w1xm/quantar-interface/README.md

# quantar-interface
Interfaces a Motorola Quantar repeater to a PC or Raspberry Pi for use with the AllStarLink controller.
