w1xm/quantar-interface/docs/EEPROM.md

# EEPROM

The interface board contains a 93C46 EEPROM chip that stores USB device
information and audio path settings for the CM119A. It is composed of 64x
16-bit words (128 bytes total)

## Format

The format is described in section 7.1.3 of the CM119A datasheet. Note, however,
that length fields for the serial, product, and manufacturer strings should be 
calculated: `2 * (real string length + 1)`. E.g., the string "ACME, Inc" should
be programmed with length `2*(9 + 1) = 20 or 0x14`. The datasheet does not make
this clear; this was determined with trial and error until I noticed the pattern.

### EEPROM contents used in device

This is a hex dump of the EEPROM as used in quantar-interface

```
Word
Address   0/8  1/9  2/A  3/B   4/C  5/D  6/E  7/F
00000000: 6707 0d8c 013a 300c  3030 3130 0000 0000  .g..:..0 0001....
00000008: 0000 0000 5130 6175  746e 7261 4920 746e  ....0Qua ntar Int
00000010: 7265 6166 6563 5220  7665 4120 0000 0000  erface R ev A....
00000018: 0000 0000 4b0e 3844  4859 0042 0000 0000  .....KD8 YHB.....
00000020: 0000 0000 0000 0000  0000 0000 0000 0000  ........ ........
00000028: 0000 0000 ffff ffff  ffff ffff ffff ffff  ........ ........
00000030: ffff ffff ffff ffff  ffff ffff ffff ffff  ........ ........
00000038: ffff ffff ffff ffff  ffff ffff ffff ffff  ........ ........
```

See `quantar_interface_eeprom.bin`. Mind the endianness.

 * VID = `0x0d8c` (C-Media, default)
 * PID = `0x013a` (default)
 * SN = `"00001"` (ASCII, please change this to something unique, len 0x0c)
 * Product = `"Quantar Interface Rev A"` (len 0x30)
 * Mfg = `"KD8YHB"` (len 0x0e)

## Programming
Is it possible to access the EEPROM via USB HID, but I didn't want to deal with
writing a tool for that, so I simply use an XGecu TL866-II universal programmer
to write in the data, then solder the chip to the board.
