w1xm/quantar-interface/pcb/quantar-interface/master_bom.ods

Ref | Qnty | Value | Footprint | Description | Vendor | Part #
C1, C7, C18, | 3 | 4.7uF | Capacitor_SMD:CP_Elec_4x5.4 | Polarized capacitor | DK | PCE4290CT-ND
C2, C6, C14, C32, C35, C36, | 6 | 0.1uF | Capacitor_SMD:C_0805_2012Metric_Pad1.15x1.40mm_HandSolder | Unpolarized capacitor | LCSC | C49678
C3, C4, | 2 | 47p | Capacitor_SMD:C_0805_2012Metric_Pad1.15x1.40mm_HandSolder | Unpolarized capacitor | LCSC | C14857
C5, C9, C11, C12, C16, | 5 | 47uF | Capacitor_SMD:CP_Elec_6.3x5.4 | Polarized capacitor | DK | PCE3961CT-ND
C8, C13, | 2 | 4.7uF | Capacitor_SMD:C_0805_2012Metric_Pad1.15x1.40mm_HandSolder | Unpolarized capacitor | LCSC | C1779
C15, C34, | 2 | 47pF | Capacitor_SMD:C_0805_2012Metric_Pad1.15x1.40mm_HandSolder | Unpolarized capacitor | LCSC | C14857
C17, C24, C27, | 3 | 0.47uF | Capacitor_SMD:C_1206_3216Metric_Pad1.42x1.75mm_HandSolder | Polarized capacitor | DK | 399-3695-1-ND
C19, C23, | 2 | 22uF | Capacitor_SMD:CP_Elec_6.3x5.4 | Polarized capacitor | DK | PCE3899CT-ND
C20, C25, C26, C28, | 4 | 10uF | Capacitor_SMD:CP_Elec_4x5.8 | Polarized capacitor | DK | PCE3782CT-ND
C21, C22, | 2 | 12pF | Capacitor_SMD:C_0805_2012Metric_Pad1.15x1.40mm_HandSolder | Unpolarized capacitor | LCSC | C1792
C29, C33, | 2 | 1uF | Capacitor_SMD:CP_Elec_4x4.5 | Polarized capacitor | DK | PCE3912CT-ND
C31, | 1 | 0.01uF | Capacitor_SMD:C_0805_2012Metric_Pad1.15x1.40mm_HandSolder | Unpolarized capacitor | LCSC | C1710
D1, | 1 | LED_USB | LED_SMD:LED_0805_2012Metric_Pad1.15x1.40mm_HandSolder | Light emitting diode | LCSC | C2297
D2, D3, | 2 | B340LA | Diode_SMD:D_SMA_Handsoldering | Schottky diode | DK | B340LA-FDICT-ND
D4, D5, D6, D7, | 4 | TVS | Diode_SMD:D_SOD-323_HandSoldering | Bidirectional transient-voltage-suppression diode | DK | DF2B7AFUH3FCT-ND
D8, | 1 | LED_12V | LED_SMD:LED_0805_2012Metric_Pad1.15x1.40mm_HandSolder | Light emitting diode | LCSC | C2297
D9, | 1 | LED_5VD | LED_SMD:LED_0805_2012Metric_Pad1.15x1.40mm_HandSolder | Light emitting diode | LCSC | C2297
D10, | 1 | LED_5VA | LED_SMD:LED_0805_2012Metric_Pad1.15x1.40mm_HandSolder | Light emitting diode | LCSC | C2297
D11, | 1 | LED_HEARTBEAT | LED_SMD:LED_0805_2012Metric_Pad1.15x1.40mm_HandSolder | Light emitting diode | LCSC | C2297
D12, D14, | 2 | 1N4148 | Diode_SMD:D_SOD-523 | Diode | DK | 1N4148XTPMSCT-ND
D13, | 1 | LED_ALARM | LED_SMD:LED_0805_2012Metric_Pad1.15x1.40mm_HandSolder | Light emitting diode | LCSC | C84256
D15, | 1 | LED_SPARE_OUT | LED_SMD:LED_0805_2012Metric_Pad1.15x1.40mm_HandSolder | Light emitting diode | LCSC | C2296
D16, | 1 | LED_PTT | LED_SMD:LED_0805_2012Metric_Pad1.15x1.40mm_HandSolder | Light emitting diode | LCSC | C2296
D17, | 1 | LED_WDOG | LED_SMD:LED_0805_2012Metric_Pad1.15x1.40mm_HandSolder | Light emitting diode | LCSC | C2297
D18, | 1 | LED_PL | LED_SMD:LED_0805_2012Metric_Pad1.15x1.40mm_HandSolder | Light emitting diode | LCSC | C2296
D19, | 1 | LED_COS | LED_SMD:LED_0805_2012Metric_Pad1.15x1.40mm_HandSolder | Light emitting diode | LCSC | C2296
D20, | 1 | LED_FS | LED_SMD:LED_0805_2012Metric_Pad1.15x1.40mm_HandSolder | Light emitting diode | LCSC | C2296
D21, | 1 | LED_TI | LED_SMD:LED_0805_2012Metric_Pad1.15x1.40mm_HandSolder | Light emitting diode | LCSC | C84256
D22, | 1 | LED_SD | LED_SMD:LED_0805_2012Metric_Pad1.15x1.40mm_HandSolder | Light emitting diode | LCSC | C2296
D23, | 1 | LED_SI | LED_SMD:LED_0805_2012Metric_Pad1.15x1.40mm_HandSolder | Light emitting diode | LCSC | C2296
F1, F2, | 2 | PTC 3A | Fuse:Fuse_2920_7451Metric_Pad2.10x5.45mm_HandSolder | Resettable fuse, polymeric positive temperature coefficient, small symbol | DK | ‎SMDC300F/24-2CT-ND‎
F3, F4, | 2 | PTC 1A | Fuse:Fuse_1210_3225Metric_Pad1.42x2.65mm_HandSolder | Resettable fuse, polymeric positive temperature coefficient, small symbol | DK | 507-1786-1-ND
FB1, FB2, | 2 | Ferrite_Bead_Small | Inductor_SMD:L_0805_2012Metric_Pad1.15x1.40mm_HandSolder | Ferrite bead, small symbol | DK | 240-2551-1-ND
FB3, | 1 | Ferrite | Inductor_SMD:L_0805_2012Metric_Pad1.15x1.40mm_HandSolder | Ferrite bead, small symbol | DK | 240-2551-1-ND
J1, | 1 | DC Input | Connector_BarrelJack:BarrelJack_Horizontal | DC Barrel Jack with an internal switch | DK | CP-002A-ND
J2, | 1 | USB_A | Connector_USB:USB_A_Stewart_SS-52100-001_Horizontal | USB Type A connector | DK | SS-52100-001
J3, | 1 | USB_B | Connector_USB:USB_B_OST_USB-B1HSxx_Horizontal | USB Type B connector | DK | ED2983-ND
J4, | 1 | GPIO | Connector_PinHeader_2.54mm:PinHeader_1x03_P2.54mm_Vertical | Generic connector, single row, 01x03, script generated (kicad-library-utils/schlib/autogen/connector/) | Generic | 0.1” header
J5, | 1 | Quantar Audio | Connector_Phoenix_MC:PhoenixContact_MC_1,5_5-G-3.5_1x05_P3.50mm_Horizontal | Generic screw terminal, single row, 01x05, script generated (kicad-library-utils/schlib/autogen/connector/) | DK | WM7773-ND
J6, | 1 | Ext. Alarm Contact | Connector_Phoenix_MC:PhoenixContact_MC_1,5_3-G-3.5_1x03_P3.50mm_Horizontal | Generic screw terminal, single row, 01x03, script generated (kicad-library-utils/schlib/autogen/connector/) | DK | WM7771-ND
J7, | 1 | Ext. TX Inhb. | Connector_Phoenix_MC:PhoenixContact_MC_1,5_2-G-3.5_1x02_P3.50mm_Horizontal | Generic screw terminal, single row, 01x02, script generated (kicad-library-utils/schlib/autogen/connector/) | DK | WM7770-ND
J8, | 1 | Quantar | Connector_Phoenix_MC:PhoenixContact_MC_1,5_13-G-3.5_1x13_P3.50mm_Horizontal | Generic screw terminal, single row, 01x13, script generated (kicad-library-utils/schlib/autogen/connector/) | DK | WM7781-ND
J9, | 1 | 5V Out | Connector_PinHeader_2.54mm:PinHeader_1x02_P2.54mm_Vertical | Generic connector, single row, 01x02, script generated (kicad-library-utils/schlib/autogen/connector/) | Generic | 0.1” header
JP2, | 1 | Watchdog Bypass | Connector_PinHeader_2.54mm:PinHeader_1x03_P2.54mm_Vertical | Jumper, 3-pole, pins 1+2 closed/bridged | Generic | 0.1” header
K1, | 1 | G6S-2 | Relay_THT:Relay_DPDT_Omron_G6S-2 | Compact, Industry-Standard 2-pole relay, designed to switch 2A Signal Loads, Single-side Stable | DK | 399-11029-5-ND
L1, | 1 | 33uH | Inductor_SMD:L_12x12mm_H4.5mm | Inductor | DK | P19782CT-ND
L2, | 1 | 4.7uH | Inductor_SMD:L_1008_2520Metric | Inductor | DK | 587-2187-1-ND
Q1, | 1 | DMP3056L-7 | Package_TO_SOT_SMD:SOT-23 | P-MOSFET transistor, gate/source/drain | DK | DMP3056L-7DICT-ND
Q2, Q3, Q4, Q5, Q6, | 5 | 2N7002 | Package_TO_SOT_SMD:SOT-23 | 0.115A Id, 60V Vds, N-Channel MOSFET, SOT-23 | LCSC | C8545
R1, R14, R16, R17, R23, R24, R25, R26, R27, R28, R29, R30, R31, R32, R33, R38, R39, R41, R42, R43, R44, | 21 | 330 | Resistor_SMD:R_0805_2012Metric_Pad1.15x1.40mm_HandSolder | Resistor | LCSC | C17630
R2, R3, R45, | 3 | 22 | Resistor_SMD:R_0805_2012Metric_Pad1.15x1.40mm_HandSolder | Resistor | LCSC | C17561
R6, | 1 | 1.5K | Resistor_SMD:R_0805_2012Metric_Pad1.15x1.40mm_HandSolder | Resistor | LCSC | C4310
R7, R8, R9, R40, | 4 | 0 | Resistor_SMD:R_0805_2012Metric_Pad1.15x1.40mm_HandSolder | Resistor | LCSC | C17477
R10, | 1 | 75K 1% | Resistor_SMD:R_0805_2012Metric_Pad1.15x1.40mm_HandSolder | Resistor | LCSC | C17819
R11, | 1 | 10K 1% | Resistor_SMD:R_0805_2012Metric_Pad1.15x1.40mm_HandSolder | Resistor | LCSC | C17414
R12, R20, | 2 | 1M | Resistor_SMD:R_0805_2012Metric_Pad1.15x1.40mm_HandSolder | Resistor | LCSC | C17514
R13, R22, | 2 | 2.2K | Resistor_SMD:R_0805_2012Metric_Pad1.15x1.40mm_HandSolder | Resistor | LCSC | C17520
R15, | 1 | 100K | Resistor_SMD:R_0805_2012Metric_Pad1.15x1.40mm_HandSolder | Resistor | LCSC | C17407
R18, R19, R21, | 3 | 4.7K | Resistor_SMD:R_0805_2012Metric_Pad1.15x1.40mm_HandSolder | Resistor | LCSC | C17673
R34, R35, R36, R37, R46, | 5 | 10K | Resistor_SMD:R_0805_2012Metric_Pad1.15x1.40mm_HandSolder | Resistor | LCSC | C17414
RV1, RV2, | 2 | 100K | Potentiometer_THT:Potentiometer_Bourns_3296W_Vertical | Potentiometer | DK | 490-2876-ND
SW1, | 1 | SW_TX_INHB | Button_Switch_THT:SW_Slide_1P2T_CK_OS102011MS2Q | Switch, single pole double throw | DK | CKN9542-ND
SW2, | 1 | SW_PTT_INHB | Button_Switch_THT:SW_Slide_1P2T_CK_OS102011MS2Q | Switch, single pole double throw | DK | CKN9542-ND
SW3, | 1 | Force PTT | Button_Switch_SMD:SW_Push_1P1T_NO_CK_KMR2 | Pushbutton | DK | 401-1431-1-ND
T1, T2, | 2 | Transformer | quantar-interface:Transformer | 1:1 Isolation transformer for quantar phone lines | DK | MT7207-ND
U1, | 1 | M93C46 | Package_SO:SO-8_3.9x4.9mm_P1.27mm | EEPROM for configuring USB audio codec | DK | 497-8590-5-ND
U2, | 1 | LM386 | Package_SO:SO-8_3.9x4.9mm_P1.27mm | Low Voltage Audio Power Amplifier, DIP-8/SOIC-8/SSOP-8 | LCSC | C23573
U3, | 1 | TPS562200 | Package_TO_SOT_SMD:SOT-23-6 | 2A Synchronous Step-Down Voltage Regulator, Adjustable Output Voltage, 4.5-17V Input Voltage, SOT-23-6 | DK | 296-39631-1-ND
U4, | 1 | AP1506 | Package_TO_SOT_SMD:TO-263-5_TabPin6 | 5V Switching regulator | DK | AP1506-50K5G-13CT-ND
U5, | 1 | CM119A | Package_QFP:LQFP-48_7x7mm_P0.5mm | USB Audio codec | Symmetry Electronics
U6, | 1 | LM1117-5.0 | Package_TO_SOT_SMD:SOT-223-3_TabPin2 | 800mA Low-Dropout Linear Regulator, 5.0V fixed output, TO-220/TO-252/TO-263/SOT-223 | DK | LM1117MP-5.0/NOPBCT-ND
U7, | 1 | LM555 | Package_SO:SOIC-8_3.9x4.9mm_P1.27mm | Timer, DIP-8/SOIC-8/SSOP-8 | DK | LM555CMX/NOPBCT-ND
U8, U9, U10, U11, U12, U13, U14, | 7 | 4N27 | Package_DIP:DIP-6_W7.62mm_SMDSocket_SmallPads | DC Optocoupler Base Connected, Vce 30V, CTR 10%, Viso 2500V, DIP6 | DK | 4N27SM-ND
U15, | 1 | 74HC14 | Package_SO:SOIC-14_3.9x8.7mm_P1.27mm | Hex inverter schmitt trigger | LCSC | C5605
Y1, | 1 | 12MHz | Crystal:Crystal_SMD_HC49-SD | Two pin crystal | DK | 1908-J49SMH-A-G-G-K-12M0CT-ND
