w1xm/quantar-interface/pcb/quantar-interface/quantar-interface.pdf

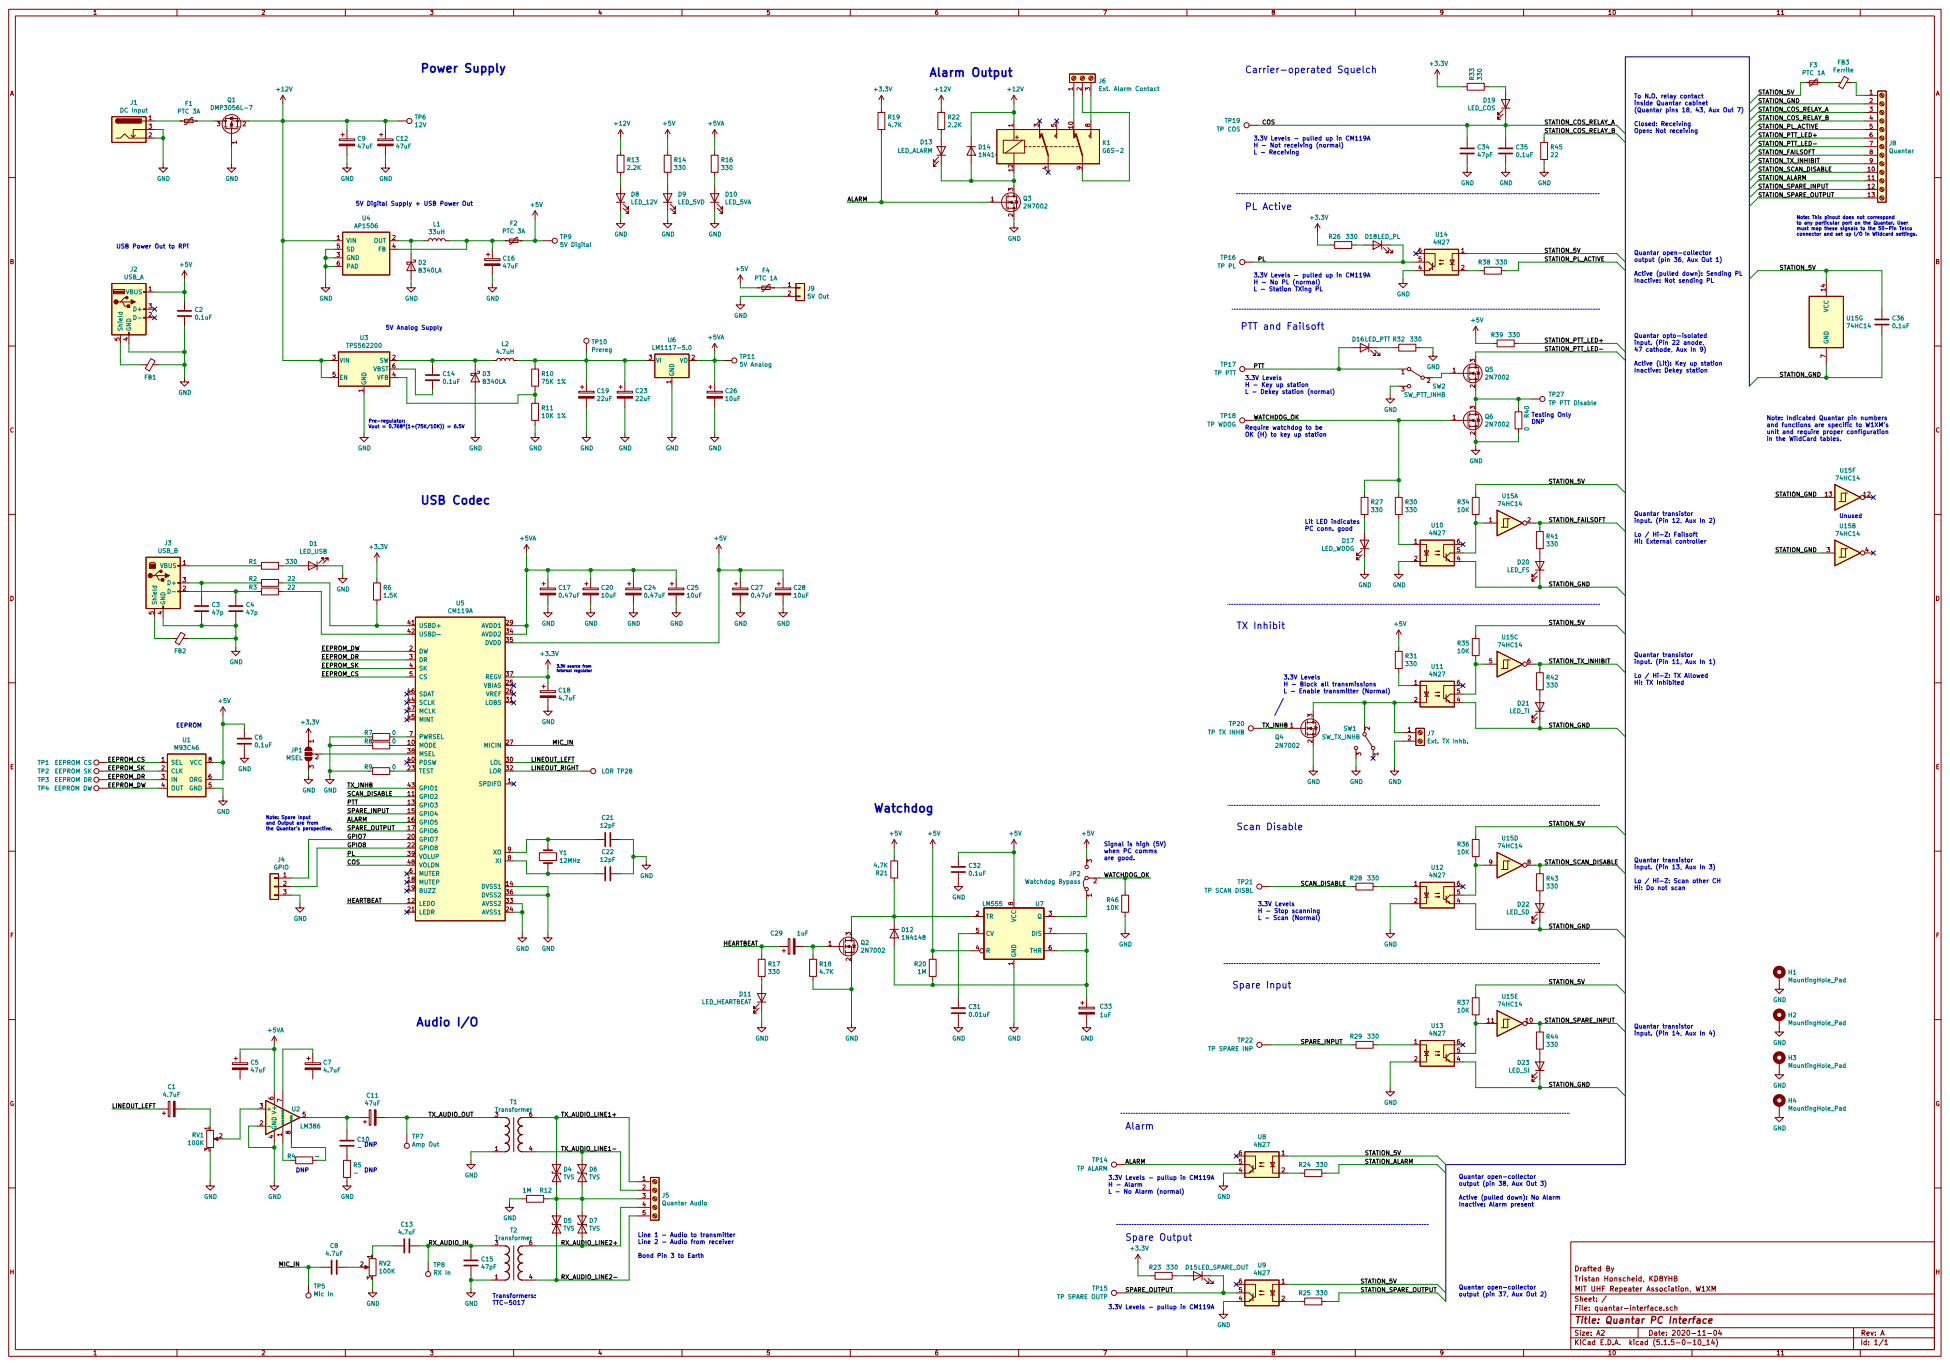
[picture p1: page 1]

To N.O. relay contact
inside Quantar cabinet (Quantar pins 18, 43, Aux Out 7)

TP16 TP PL TP19 TP COS

3.3V Levels - pulled up in CM119A
H - Not receiving (normal)
L - Receiving

5V Digital Supply + USB Power Out

Note: This pinout does not correspond
to any particular port on the Quantar. User must map these signals to the 50-Pin Telco

connector and set up I/O in Wildcard settings. Watchdog

Quantar open-collector
output (pin 36, Aux Out 1)

H - No PL (normal)
L - Station TXing PL

Active (pulled down): Sending PL
Inactive: Not sending PL

1 SW 2 VIN 3 VFB 4 EN 5 VBST 6 U3 TPS562200 C25

Active (Lit): Key up station

Inactive: Dekey station EEPROM

PTT
3.3V Levels H - Key up station

TP27 TP PTT Disable TP18 TP WDOG

Unused Note: Indicated Quantar pin numbers
and functions are specific to W1XMs
unit and require proper configuration

Require watchdog to be
OK (H) to key up station

in the WildCard tables. USB Codec

74HC14 GND
TP21 TP SCAN DISBL TP20 TP TX INHB

Quantar transistor
input. (Pin 11, Aux In 1) Lo / Hi-Z: TX Allowed Hi: TX Inhibited

Note: Spare Input and Output are from

Signal is high (5V) when PC comms are good.

input. (Pin 13, Aux In 3) Lo / Hi-Z: Scan other CH
H1MountingHole_Pad GND

Hi: Do not scan

input. (Pin 14, Aux In 4)

3.3V Levels - pullup in CM119A H - Alarm

output (pin 38, Aux Out 3)

Active (pulled down): No Alarm
Inactive: Alarm present

Drafted By
Tristan Honscheid, KD8YHB
File: quantar-interface.sch Sheet: / MIT UHF Repeater Association, W1XM

output (pin 37, Aux Out 2)

Id: 1/1 Title: Quantar PC Interface
