w1xm/quantar-interface/pcb/quantar-interface/quantar-interface.kicad_pcb

## KiCad design pcb/quantar-interface/quantar-interface.kicad_pcb (2020-12-05)

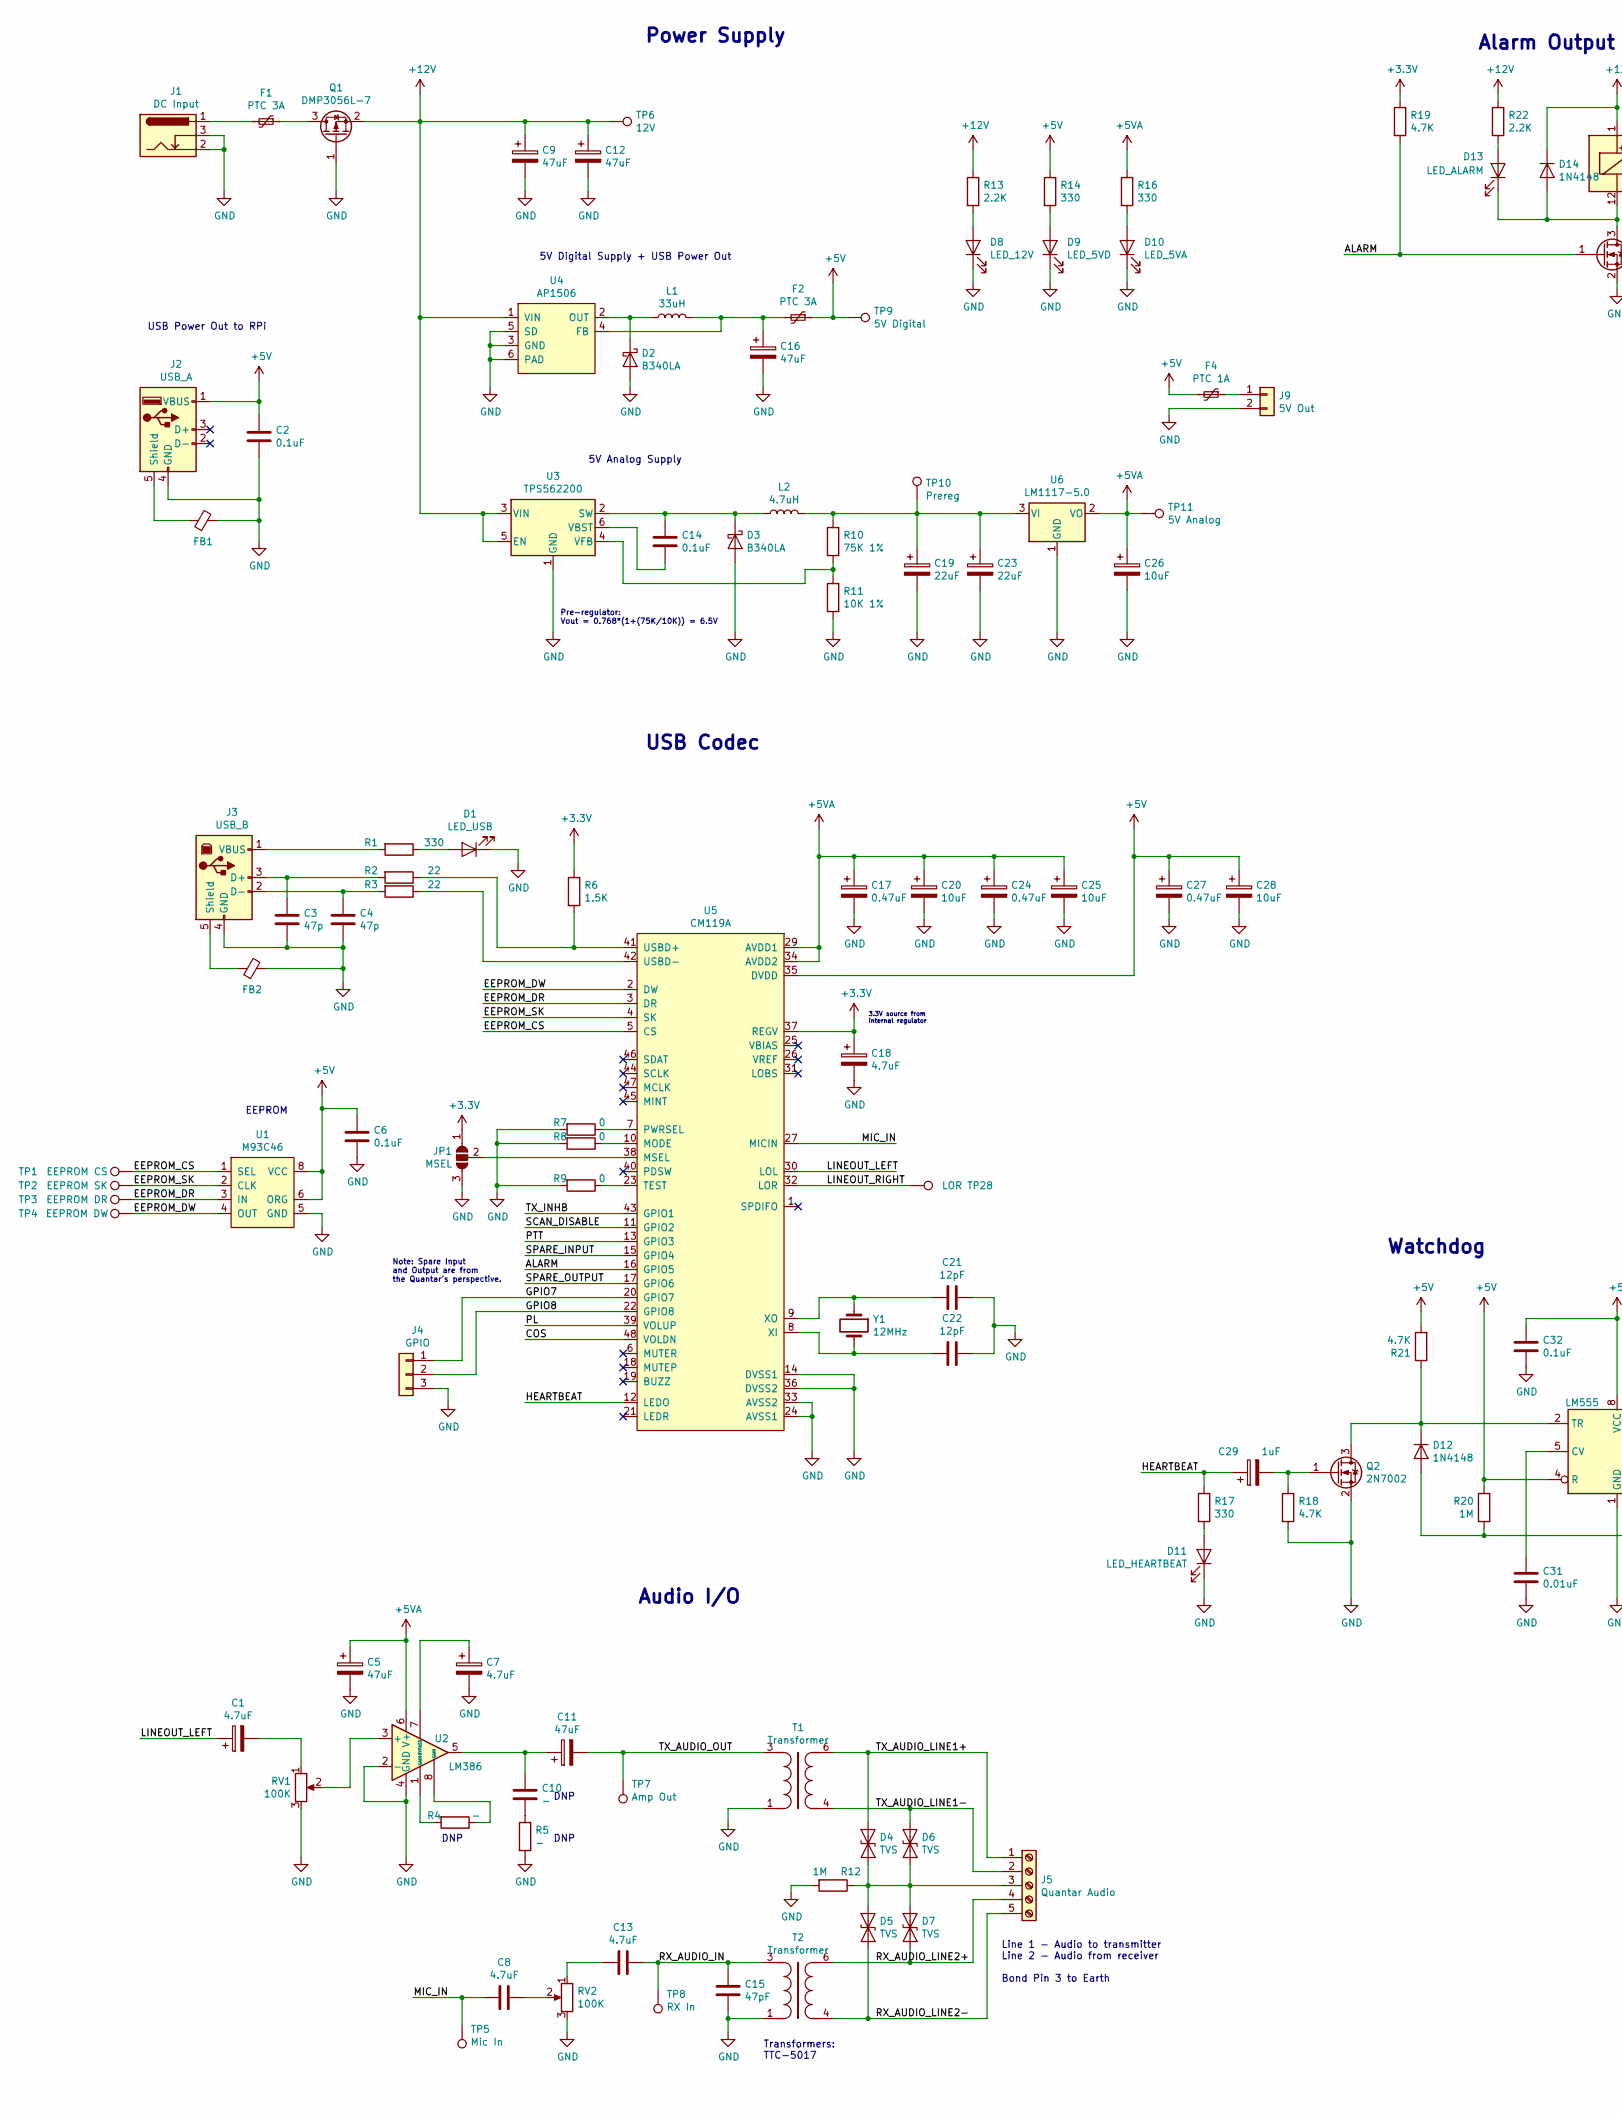
[picture p2: schematic quantar-interface.sch, Quantar PC Interface, part in row 1, column 1]

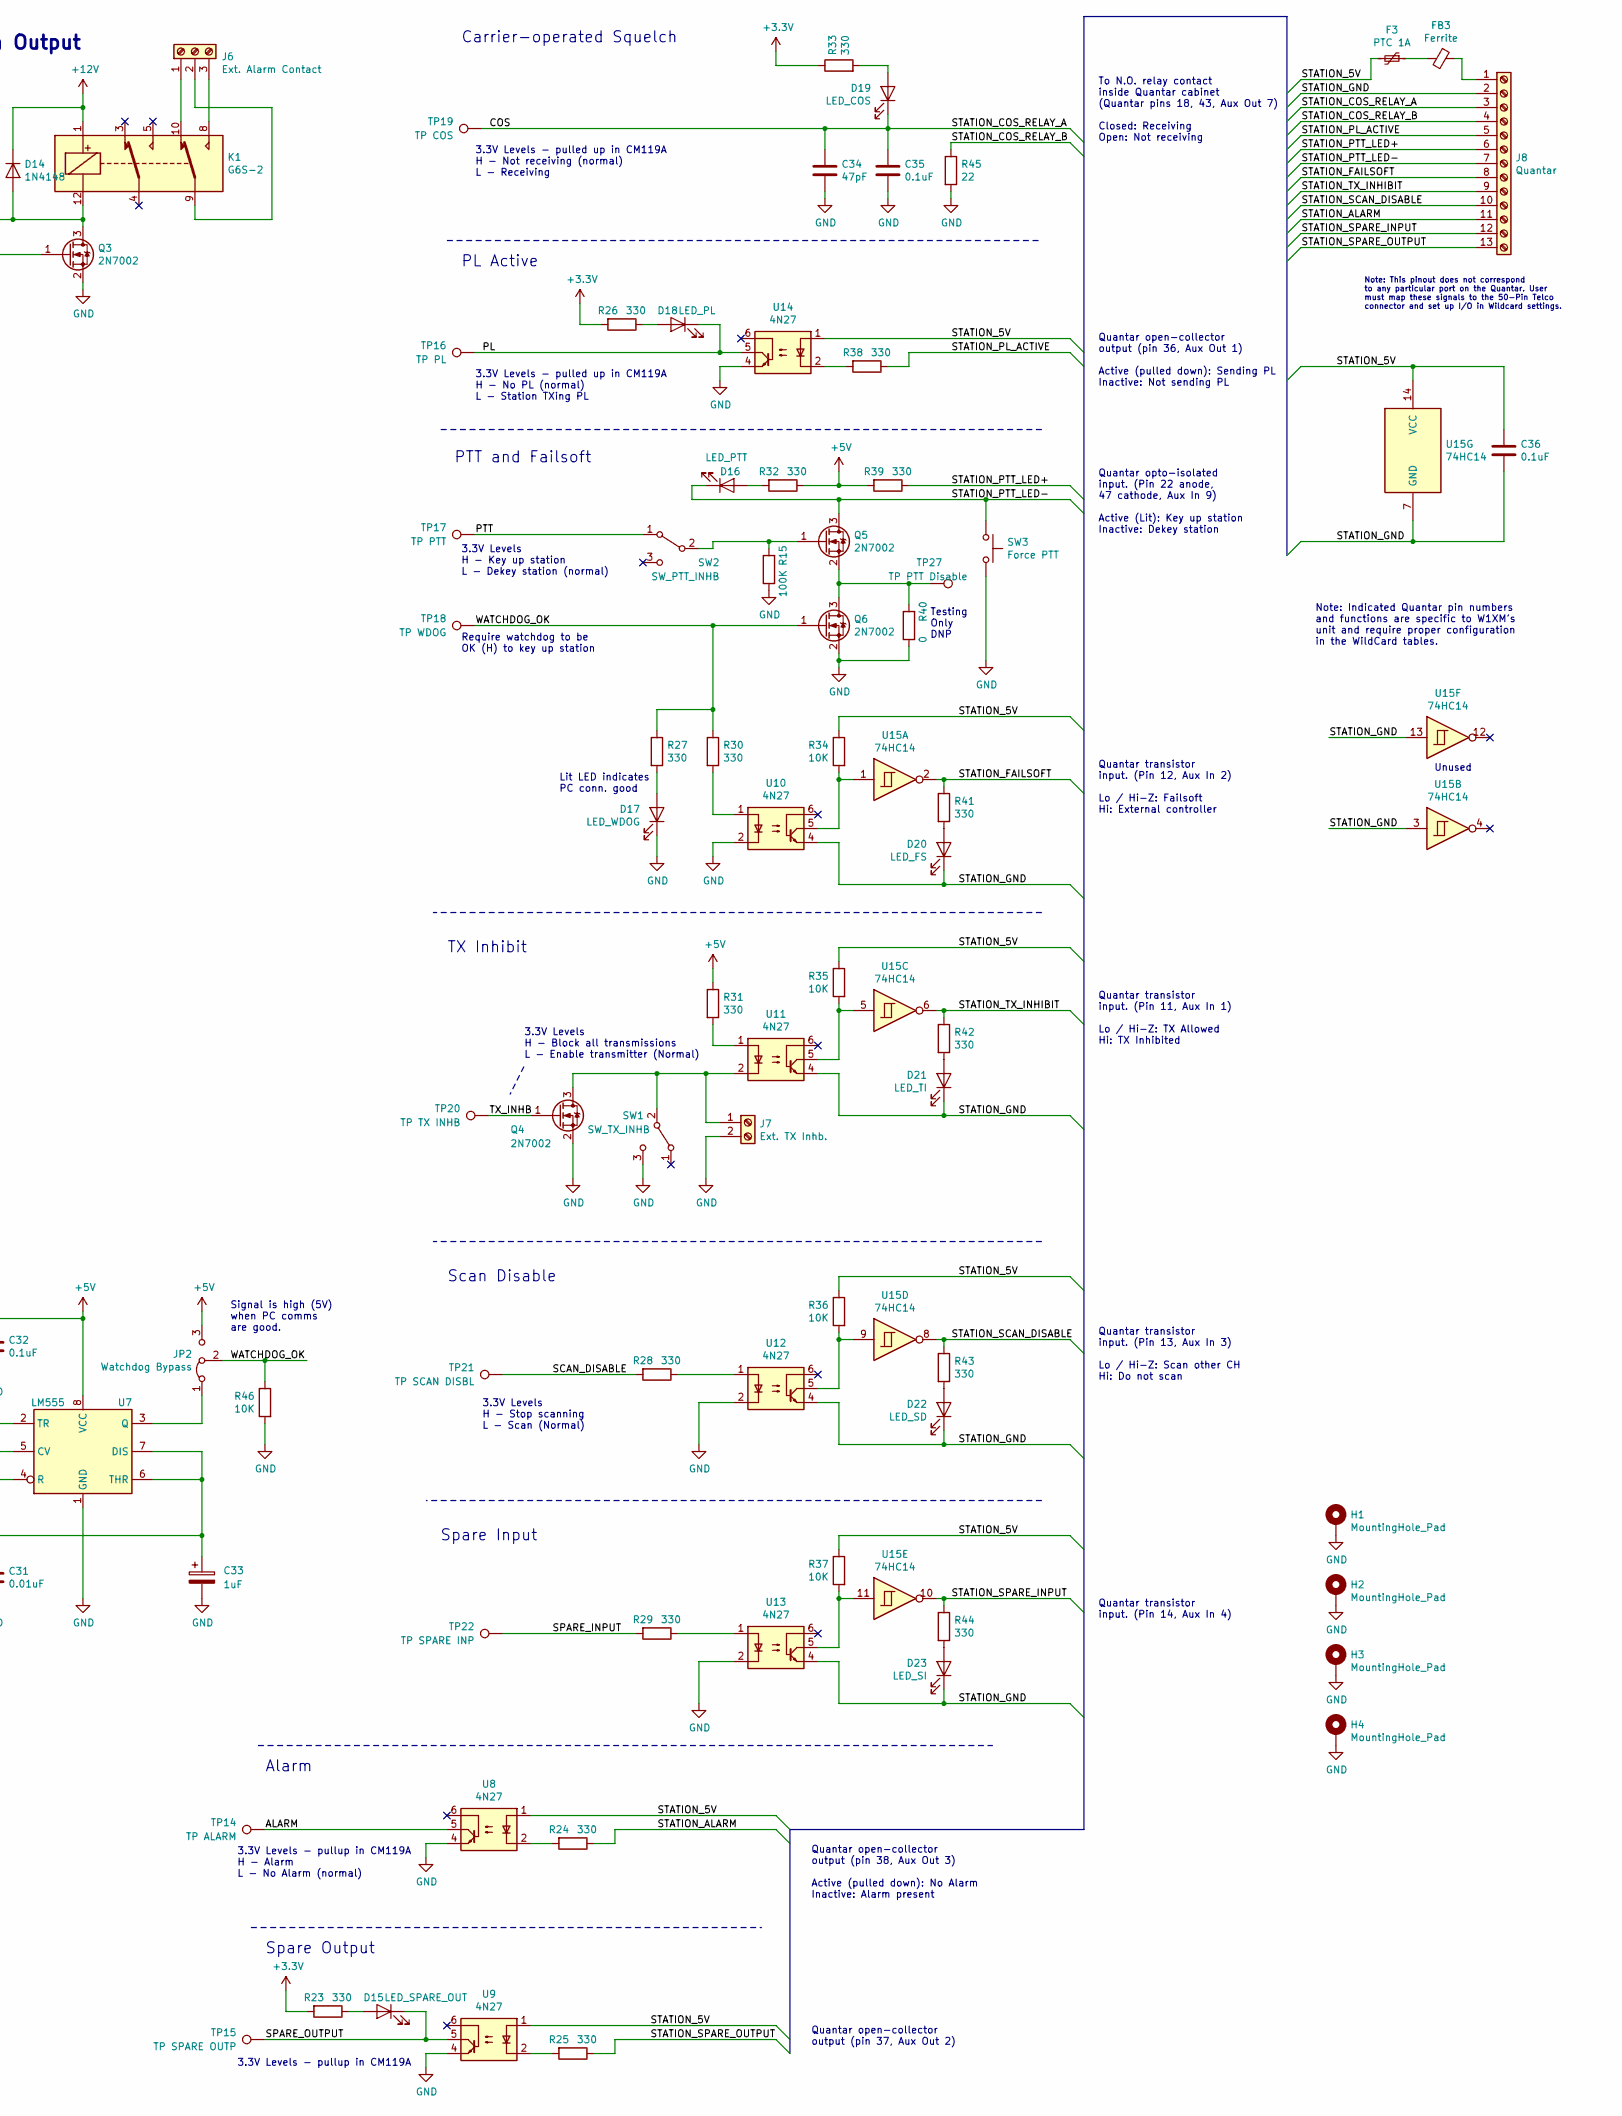
[picture p3: schematic quantar-interface.sch, Quantar PC Interface, part in row 1, column 2]

Parts:
C1, C7, C18: 4.7uF; CP_Elec_4x5.4
C2, C6, C14, C32, C35, C36: 0.1uF; C_0805_2012Metric_Pad1.15x1.40mm_HandSolder
C3, C4: 47p; C_0805_2012Metric_Pad1.15x1.40mm_HandSolder
C5, C9, C11, C12, C16: 47uF; CP_Elec_6.3x5.4
C8, C13: 4.7uF; C_0805_2012Metric_Pad1.15x1.40mm_HandSolder
C10: -; C_0805_2012Metric_Pad1.15x1.40mm_HandSolder
C15, C34: 47pF; C_0805_2012Metric_Pad1.15x1.40mm_HandSolder
C17, C24, C27: 0.47uF; C_1206_3216Metric_Pad1.42x1.75mm_HandSolder
C19, C23: 22uF; CP_Elec_6.3x5.4
C20, C25, C26, C28: 10uF; CP_Elec_4x5.8
C21, C22: 12pF; C_0805_2012Metric_Pad1.15x1.40mm_HandSolder
C29, C33: 1uF; CP_Elec_4x4.5
C31: 0.01uF; C_0805_2012Metric_Pad1.15x1.40mm_HandSolder
D1: LED_USB; LED_0805_2012Metric_Pad1.15x1.40mm_HandSolder
D2, D3: B340LA; D_SMA_Handsoldering
D4, D5, D6, D7: TVS; D_SOD-323_HandSoldering
D8: LED_12V; LED_0805_2012Metric_Pad1.15x1.40mm_HandSolder
D9: LED_5VD; LED_0805_2012Metric_Pad1.15x1.40mm_HandSolder
D10: LED_5VA; LED_0805_2012Metric_Pad1.15x1.40mm_HandSolder
D11: LED_HEARTBEAT; LED_0805_2012Metric_Pad1.15x1.40mm_HandSolder
D12, D14: 1N4148; D_SOD-523
D13: LED_ALARM; LED_0805_2012Metric_Pad1.15x1.40mm_HandSolder
D15: LED_SPARE_OUT; LED_0805_2012Metric_Pad1.15x1.40mm_HandSolder
D16: LED_PTT; LED_0805_2012Metric_Pad1.15x1.40mm_HandSolder
D17: LED_WDOG; LED_0805_2012Metric_Pad1.15x1.40mm_HandSolder
D18: LED_PL; LED_0805_2012Metric_Pad1.15x1.40mm_HandSolder
D19: LED_COS; LED_0805_2012Metric_Pad1.15x1.40mm_HandSolder
D20: LED_FS; LED_0805_2012Metric_Pad1.15x1.40mm_HandSolder
D21: LED_TI; LED_0805_2012Metric_Pad1.15x1.40mm_HandSolder
D22: LED_SD; LED_0805_2012Metric_Pad1.15x1.40mm_HandSolder
D23: LED_SI; LED_0805_2012Metric_Pad1.15x1.40mm_HandSolder
F1, F2: PTC 3A; Fuse_2920_7451Metric_Pad2.10x5.45mm_HandSolder
F3, F4: PTC 1A; Fuse_1210_3225Metric_Pad1.42x2.65mm_HandSolder
FB1, FB2: Ferrite_Bead_Small; L_0805_2012Metric_Pad1.15x1.40mm_HandSolder
FB3: Ferrite; L_0805_2012Metric_Pad1.15x1.40mm_HandSolder
H1, H2, H3, H4: MountingHole_Pad; MountingHole_4mm_Pad_Via
J1: DC Input; BarrelJack_Horizontal
J2: USB_A; USB_A_Stewart_SS-52100-001_Horizontal
J3: USB_B; USB_B_OST_USB-B1HSxx_Horizontal
J4: GPIO; PinHeader_1x03_P2.54mm_Vertical
J5: Quantar Audio; PhoenixContact_MC_1,5_5-G-3.5_1x05_P3.50mm_Horizontal
J6: Ext. Alarm Contact; PhoenixContact_MC_1,5_3-G-3.5_1x03_P3.50mm_Horizontal
J7: Ext. TX Inhb.; PhoenixContact_MC_1,5_2-G-3.5_1x02_P3.50mm_Horizontal
J8: Quantar; PhoenixContact_MC_1,5_13-G-3.5_1x13_P3.50mm_Horizontal
J9: 5V Out; PinHeader_1x02_P2.54mm_Vertical
JP1: MSEL; SolderJumper-3_P1.3mm_Bridged12_RoundedPad1.0x1.5mm_NumberL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
JP2: Watchdog Bypass; PinHeader_1x03_P2.54mm_Vertical
K1: G6S-2; Relay_DPDT_Omron_G6S-2
L1: 33uH; L_12x12mm_H4.5mm
L2: 4.7uH; L_1008_2520Metric
Q1: DMP3056L-7; SOT-23
Q2, Q3, Q4, Q5, Q6: 2N7002; SOT-23
R1, R14, R16, R17, R23, R24, R25, R26, R27, R28, R29, R30, R31, R32, R33, R38, R39, R41, R42, R43, R44: 330; R_0805_2012Metric_Pad1.15x1.40mm_HandSolder
R2, R3, R45: 22; R_0805_2012Metric_Pad1.15x1.40mm_HandSolder
R4, R5: -; R_0805_2012Metric_Pad1.15x1.40mm_HandSolder
R6: 1.5K; R_0805_2012Metric_Pad1.15x1.40mm_HandSolder
R7, R8, R9, R40: 0; R_0805_2012Metric_Pad1.15x1.40mm_HandSolder
R10: 75K 1%; R_0805_2012Metric_Pad1.15x1.40mm_HandSolder
R11: 10K 1%; R_0805_2012Metric_Pad1.15x1.40mm_HandSolder
R12, R20: 1M; R_0805_2012Metric_Pad1.15x1.40mm_HandSolder
R13, R22: 2.2K; R_0805_2012Metric_Pad1.15x1.40mm_HandSolder
R15: 100K; R_0805_2012Metric_Pad1.15x1.40mm_HandSolder
R18, R19, R21: 4.7K; R_0805_2012Metric_Pad1.15x1.40mm_HandSolder
R34, R35, R36, R37, R46: 10K; R_0805_2012Metric_Pad1.15x1.40mm_HandSolder
RV1, RV2: 100K; Potentiometer_Bourns_3296W_Vertical
SW1: SW_TX_INHB; SW_Slide_1P2T_CK_OS102011MS2Q
SW2: SW_PTT_INHB; SW_Slide_1P2T_CK_OS102011MS2Q
SW3: Force PTT; SW_Push_1P1T_NO_CK_KMR2
T1, T2: Transformer
TP1: EEPROM CS; TestPoint_Pad_1.0x1.0mm
TP2: EEPROM SK; TestPoint_Pad_1.0x1.0mm
TP3: EEPROM DR; TestPoint_Pad_1.0x1.0mm
TP4: EEPROM DW; TestPoint_Pad_1.0x1.0mm
TP5: Mic In; TestPoint_Pad_1.0x1.0mm
TP6: 12V; TestPoint_Pad_1.0x1.0mm
TP7: Amp Out; TestPoint_Pad_1.0x1.0mm
TP8: RX In; TestPoint_Pad_1.0x1.0mm
TP9: 5V Digital; TestPoint_Pad_1.0x1.0mm
TP10: Prereg; TestPoint_Pad_1.0x1.0mm
TP11: 5V Analog; TestPoint_Pad_1.0x1.0mm
TP14: TP ALARM; TestPoint_Pad_1.0x1.0mm
TP15: TP SPARE OUTP; TestPoint_Pad_1.0x1.0mm
TP16: TP PL; TestPoint_Pad_1.0x1.0mm
TP17: TP PTT; TestPoint_Pad_1.0x1.0mm
TP18: TP WDOG; TestPoint_Pad_1.0x1.0mm
TP19: TP COS; TestPoint_Pad_1.0x1.0mm
TP20: TP TX INHB; TestPoint_Pad_1.0x1.0mm
TP21: TP SCAN DISBL; TestPoint_Pad_1.0x1.0mm
TP22: TP SPARE INP; TestPoint_Pad_1.0x1.0mm
TP27: TP PTT Disable; TestPoint_Pad_1.0x1.0mm
TP28: LOR; TestPoint_Pad_1.0x1.0mm
U1: M93C46; SO-8_3.9x4.9mm_P1.27mm
U2: LM386; SO-8_3.9x4.9mm_P1.27mm
U3: TPS562200; SOT-23-6
U4: AP1506; TO-263-5_TabPin6
U5: CM119A; LQFP-48_7x7mm_P0.5mm
U6: LM1117-5.0; SOT-223-3_TabPin2
U7: LM555; SOIC-8_3.9x4.9mm_P1.27mm
U8, U9, U10, U11, U12, U13, U14: 4N27; DIP-6_W7.62mm_SMDSocket_SmallPads
U15: 74HC14; SOIC-14_3.9x8.7mm_P1.27mm
Y1: 12MHz; Crystal_SMD_HC49-SD

Connections:
+3V3: C18.1, JP1.1 (A), R6.1, R19.1, R23.2, R26.2, R33.1, U5.37 (REGV)
+5V: C2.1, C6.1, C27.1, C28.1, C32.1, F2.1, F4.2, J2.1 (VBUS), JP2.3 (B), R14.1, R20.1, R21.2, R31.1, R32.1, R39.2, TP9.1, U1.6 (ORG), U1.8 (VCC), U5.35 (DVDD), U7.4 (R), U7.8 (VCC)
+5VA: C5.1, C17.1, C20.1, C24.1, C25.1, C26.1, R16.1, TP11.1, U2.6 (V+), U5.29 (AVDD1), U5.34 (AVDD2), U6.2 (VO)
+12V: C9.1, C12.1, D14.1 (K), K1.1, Q1.2 (S), R13.1, R22.1, TP6.1, U3.3 (VIN), U3.5 (EN), U4.1 (VIN)
/ALARM: Q3.1 (G), R19.2, TP14.1, U5.16 (GPIO5), U8.5
/COS: C34.1, C35.1, D19.1 (K), J8.3, TP19.1, U5.48 (VOLDN)
/EEPROM_CS: TP1.1, U1.1 (SEL), U5.5 (CS)
/EEPROM_DR: TP3.1, U1.3 (IN), U5.3 (DR)
/EEPROM_DW: TP4.1, U1.4 (OUT), U5.2 (DW)
/EEPROM_SK: TP2.1, U1.2 (CLK), U5.4 (SK)
/GPIO7: J4.1, U5.20 (GPIO7)
/GPIO8: J4.2, U5.22 (GPIO8)
/HEARTBEAT: C29.1, R17.1, U5.12 (LEDO)
/LINEOUT_LEFT: C1.1, U5.30 (LOL)
/LINEOUT_RIGHT: TP28.1, U5.32 (LOR)
/MIC_IN: C8.2, TP5.1, U5.27 (MICIN)
/PL: D18.1 (K), TP16.1, U5.39 (VOLUP), U14.5
/PTT: SW2.1 (A), TP17.1, U5.13 (GPIO3)
/RX_AUDIO_IN: C13.1, C15.1, T2.3, TP8.1
/RX_AUDIO_LINE2+: D7.2 (A2), J5.4, T2.6
/RX_AUDIO_LINE2-: D5.2 (A2), J5.5, T2.4
/SCAN_DISABLE: R28.2, TP21.1, U5.11 (GPIO2)
/SPARE_INPUT: R29.2, TP22.1, U5.15 (GPIO4)
/SPARE_OUTPUT: D15.1 (K), TP15.1, U5.17 (GPIO6), U9.5
/STATION_5V: C36.1, F3.2, R34.1, R35.1, R36.1, R37.1, U8.1, U9.1, U14.1, U15.14 (VCC)
/STATION_ALARM: J8.11, R24.1
/STATION_COS_RELAY_B: J8.4, R45.1
/STATION_FAILSOFT: J8.8, R41.1, U15.2
/STATION_GND: C36.2, D20.1 (K), D21.1 (K), D22.1 (K), D23.1 (K), J8.2, U10.4, U11.4, U12.4, U13.4, U15.3, U15.7 (GND), U15.13
/STATION_PL_ACTIVE: J8.5, R38.1
/STATION_PTT_LED+: J8.6, R39.1
/STATION_PTT_LED-: D16.1 (K), J8.7, Q5.3 (D), SW3.1
/STATION_SCAN_DISABLE: J8.10, R43.1, U15.8
/STATION_SPARE_INPUT: J8.12, R44.1, U15.10
/STATION_SPARE_OUTPUT: J8.13, R25.1
/STATION_TX_INHIBIT: J8.9, R42.1, U15.6
/TX_AUDIO_LINE1+: D4.1 (A1), J5.1, T1.6
/TX_AUDIO_LINE1-: D6.1 (A1), J5.2, T1.4
/TX_AUDIO_OUT: C11.2, T1.3, TP7.1
/TX_INHB: Q4.1 (G), TP20.1, U5.43 (GPIO1)
/WATCHDOG_OK: JP2.2 (C), Q6.1 (G), R27.1, R30.1, R46.1, TP18.1
GND: C2.2, C3.2, C4.2, C5.2, C6.2, C7.2, C9.2, C12.2, C15.2, C16.2, C17.2, C18.2, C19.2, C20.2, C21.2, C22.2, C23.2, C24.2, C25.2, C26.2, C27.2, C28.2, C31.2, C32.2, C33.2, C34.2, C35.2, D1.1 (K), D2.2 (A), D3.2 (A), D8.1 (K), D9.1 (K), D10.1 (K), D11.1 (K), D17.1 (K), FB1.2, FB2.2, H1.1, H2.1, H3.1, H4.1, J1.2, J1.3, J2.4 (GND), J3.4 (GND), J4.3, J7.2, J9.2, JP1.3 (B), Q1.1 (G), Q2.2 (S), Q3.2 (S), Q4.2 (S), Q6.2 (S), R5.2, R7.2, R8.2, R9.2, R11.2, R12.2, R15.1, R18.2, R40.1, R45.2, R46.2, RV1.3, RV2.3, SW1.3 (C), SW3.2, T1.1, T2.1, U1.5 (GND), U2.2 (-), U2.4 (GND), U3.1 (GND), U4.3 (GND), U4.5 (SD), U4.6 (PAD), U5.14 (DVSS1), U5.24 (AVSS1), U5.33 (AVSS2), U5.36 (DVSS2), U6.1 (GND), U7.1 (GND), U8.4, U9.4, U10.2, U12.2, U13.2, U14.4
unnamed: C1.2, RV1.1
unnamed: C3.1, J3.3 (D+), R2.2
unnamed: C4.1, J3.2 (D-), R3.2
unnamed: C7.1, U2.7 (BYPASS)
unnamed: C8.1, RV2.2
unnamed: C10.1, C11.1, U2.5
unnamed: C10.2, R5.1
unnamed: C13.2, RV2.1
unnamed: C14.1, D3.1 (K), L2.1, U3.2 (SW)
unnamed: C14.2, U3.6 (VBST)
unnamed: C16.1, F2.2, L1.2, U4.4 (FB)
unnamed: C19.1, C23.1, L2.2, R10.1, TP10.1, U6.3 (VI)
unnamed: C21.1, U5.9 (XO), Y1.1
unnamed: C22.1, U5.8 (XI), Y1.2
unnamed: C29.2, Q2.1 (G), R18.1
unnamed: C31.1, U7.5 (CV)
unnamed: C33.1, D12.2 (A), R20.2, U7.6 (THR), U7.7 (DIS)
unnamed: D1.2 (A), R1.1
unnamed: D2.1 (K), L1.1, U4.2 (OUT)
unnamed: D4.2 (A2), D5.1 (A1), D6.2 (A2), D7.1 (A1), J5.3, R12.1
unnamed: D8.2 (A), R13.2
unnamed: D9.2 (A), R14.2
unnamed: D10.2 (A), R16.2
unnamed: D11.2 (A), R17.2
unnamed: D12.1 (K), Q2.3 (D), R21.1, U7.2 (TR)
unnamed: D13.1 (K), D14.2 (A), K1.12, Q3.3 (D)
unnamed: D13.2 (A), R22.2
unnamed: D15.2 (A), R23.1
unnamed: D16.2 (A), R32.2
unnamed: D17.2 (A), R27.2
unnamed: D18.2 (A), R26.1
unnamed: D19.2 (A), R33.2
unnamed: D20.2 (A), R41.2
unnamed: D21.2 (A), R42.2
unnamed: D22.2 (A), R43.2
unnamed: D23.2 (A), R44.2
unnamed: F1.1, Q1.3 (D)
unnamed: F1.2, J1.1
unnamed: F3.1, FB3.2
unnamed: F4.1, J9.1
unnamed: FB1.1, J2.5 (Shield)
unnamed: FB2.1, J3.5 (Shield)
unnamed: FB3.1, J8.1
unnamed: J3.1 (VBUS), R1.2
unnamed: J6.1, K1.10
unnamed: J6.2, K1.9
unnamed: J6.3, K1.8
unnamed: J7.1, Q4.3 (D), SW1.2 (B), U11.2
unnamed: JP1.2 (C), U5.38 (MSEL)
unnamed: JP2.1 (A), U7.3 (Q)
unnamed: Q5.1 (G), R15.2, SW2.2 (B)
unnamed: Q5.2 (S), Q6.3 (D), R40.2, TP27.1
unnamed: R2.1, R6.2, U5.41 (USBD+)
unnamed: R3.1, U5.42 (USBD-)
unnamed: R4.1, U2.8 (GAIN)
unnamed: R4.2, U2.1 (GAIN)
unnamed: R7.1, U5.7 (PWRSEL)
unnamed: R8.1, U5.10 (MODE)
unnamed: R9.1, U5.23 (TEST)
unnamed: R10.2, R11.1, U3.4 (VFB)
unnamed: R24.2, U8.2
unnamed: R25.2, U9.2
unnamed: R28.1, U12.1
unnamed: R29.1, U13.1
unnamed: R30.2, U10.1
unnamed: R31.2, U11.1
unnamed: R34.2, U10.5, U15.1
unnamed: R35.2, U11.5, U15.5
unnamed: R36.2, U12.5, U15.9
unnamed: R37.2, U13.5, U15.11
unnamed: R38.2, U14.2
unnamed: RV1.2, U2.3 (+)

Notes on the sheet:
Line 1 - Audio to transmitter Line 2 - Audio from receiver Bond Pin 3 to Earth
5V Digital Supply + USB Power Out
5V Analog Supply
Pre-regulator: Vout = 0.768*(1+(75K/10K)) = 6.5V
Power Supply
USB Power Out to RPi
EEPROM
3.3V source from internal regulator
DNP
Transformers: TTC-5017
Audio I/O
Carrier-operated Squelch
3.3V Levels - pulled up in CM119A H - Not receiving (normal) L - Receiving
To N.O. relay contact inside Quantar cabinet (Quantar pins 18, 43, Aux Out 7) Closed: Receiving Open: Not receiving
Quantar opto-isolated input. (Pin 22 anode, 47 cathode, Aux In 9) Active (Lit): Key up station Inactive: Dekey station
3.3V Levels - pulled up in CM119A H - No PL (normal) L - Station TXing PL
PL Active
PTT and Failsoft
3.3V Levels H - Key up station L - Dekey station (normal)
Require watchdog to be OK (H) to key up station
Testing Only DNP
Quantar open-collector output (pin 36, Aux Out 1) Active (pulled down): Sending PL Inactive: Not sending PL
Quantar transistor input. (Pin 12, Aux In 2) Lo / Hi-Z: Failsoft Hi: External controller
Note: Indicated Quantar pin numbers and functions are specific to W1XM’s unit and require proper configuration in the WildCard tables.
Lit LED indicates PC conn. good
TX Inhibit
Quantar transistor input. (Pin 11, Aux In 1) Lo / Hi-Z: TX Allowed Hi: TX Inhibited
Scan Disable
3.3V Levels H - Block all transmissions L - Enable transmitter (Normal)
Quantar transistor input. (Pin 13, Aux In 3) Lo / Hi-Z: Scan other CH Hi: Do not scan
3.3V Levels H - Stop scanning L - Scan (Normal)
Spare Input
Quantar transistor input. (Pin 14, Aux In 4)
3.3V Levels - pullup in CM119A H - Alarm L - No Alarm (normal)
Alarm
Spare Output
Quantar open-collector output (pin 37, Aux Out 2)
USB Codec
Watchdog
Note: This pinout does not correspond to any particular port on the Quantar. User must map these signals to the 50-Pin Telco connector and set up I/O in Wildcard settings.
Signal is high (5V) when PC comms are good.
3.3V Levels - pullup in CM119A
Note: Spare Input and Output are from the Quantar’s perspective.
Alarm Output
Unused
Quantar open-collector output (pin 38, Aux Out 3) Active (pulled down): No Alarm Inactive: Alarm present

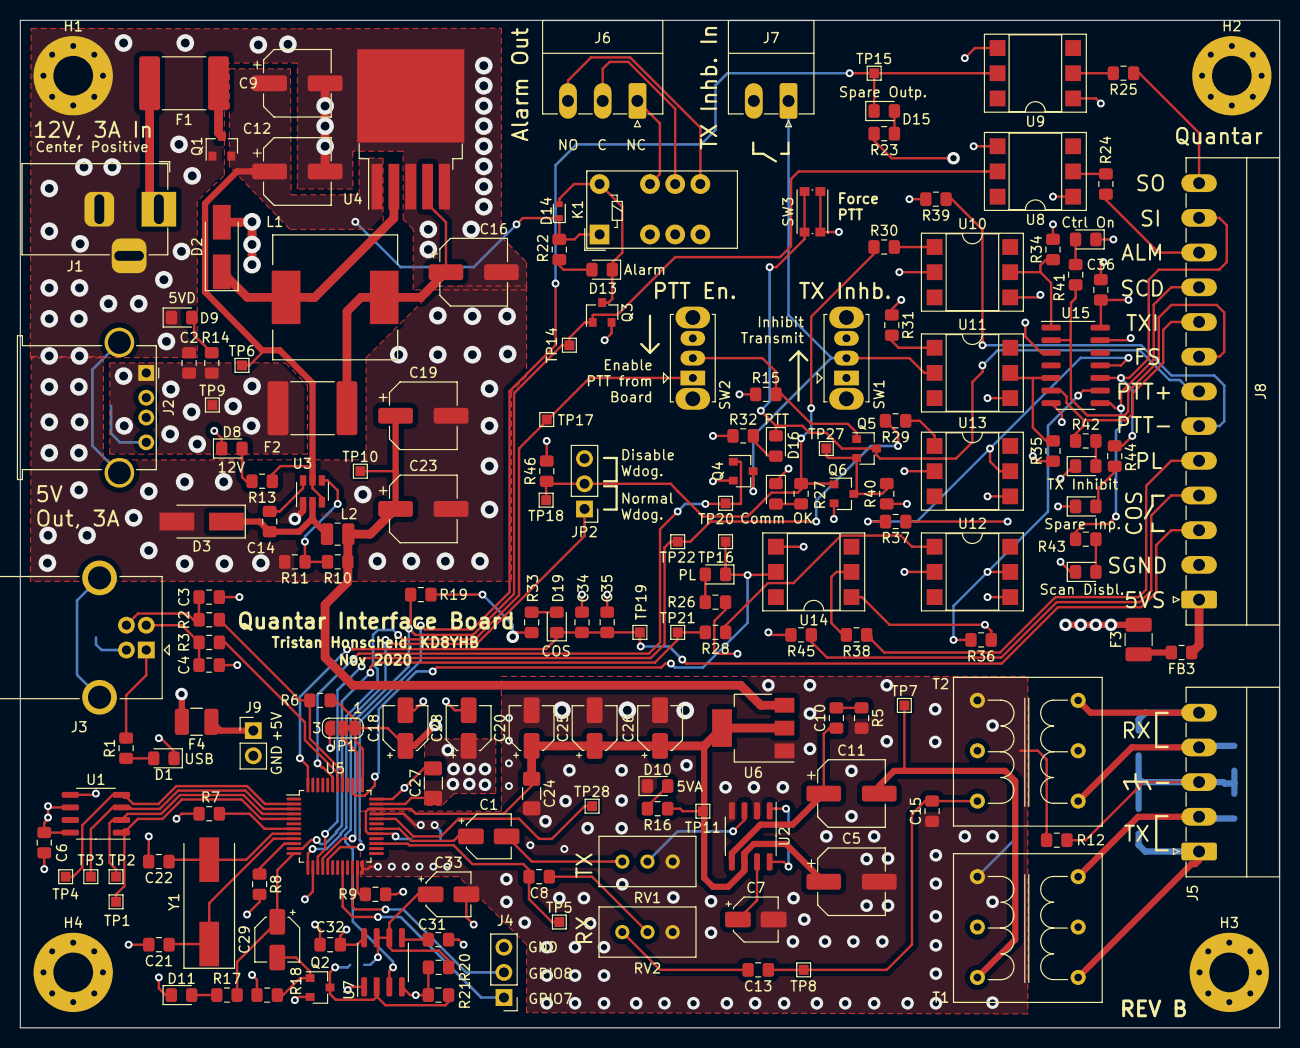
[picture p4: board quantar-interface.kicad_pcb from above]

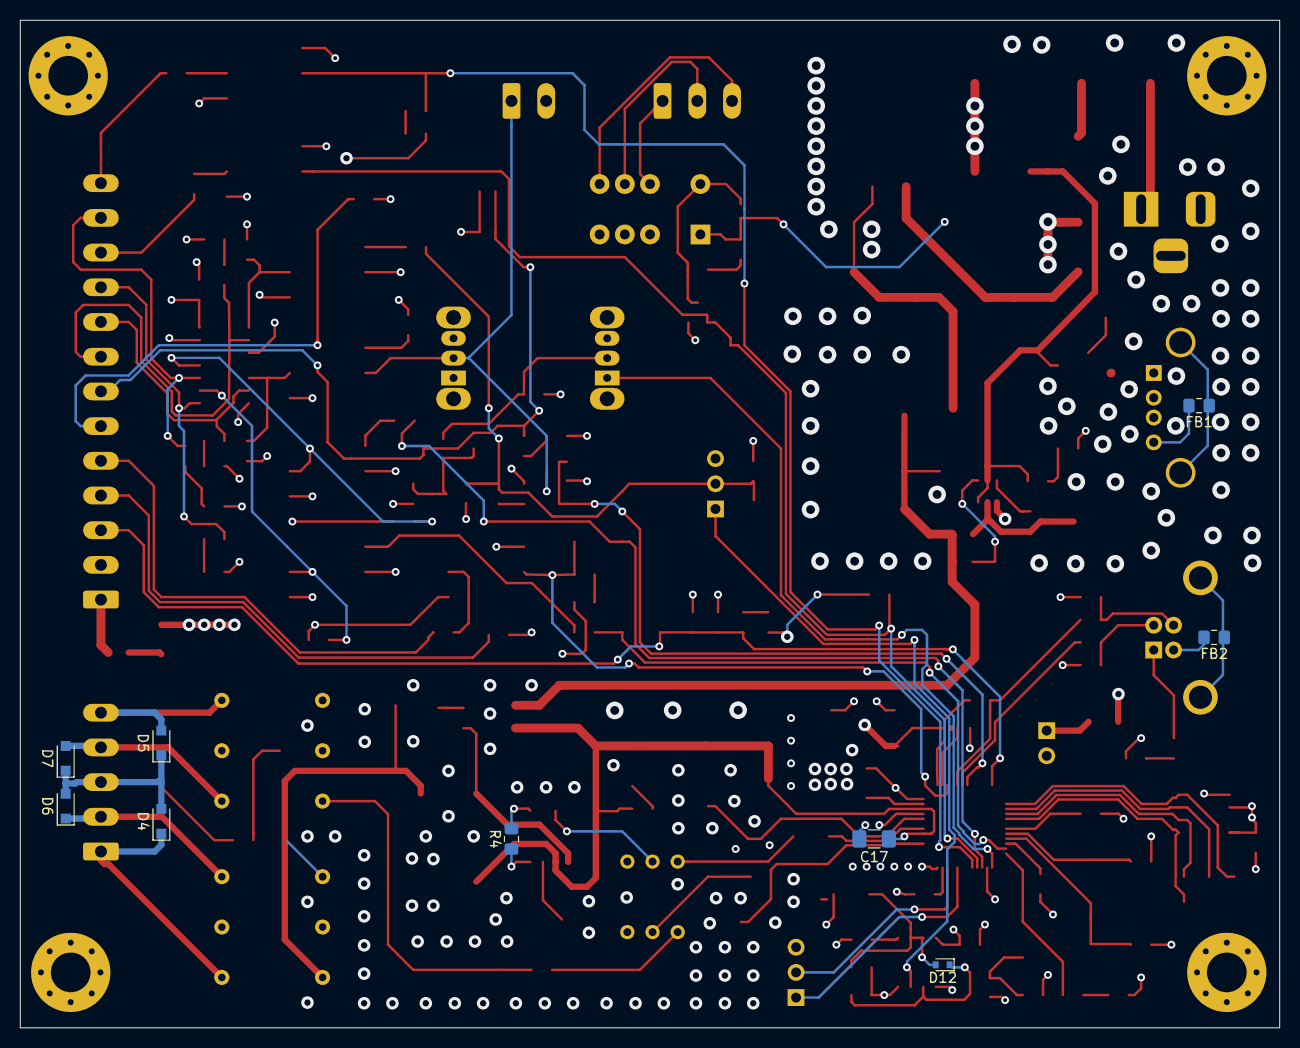
[picture p5: board quantar-interface.kicad_pcb from below]

Board: 4 copper layers, 127.0 x 101.6 mm, 180 parts (9 on the bottom side), 114 nets.
