w1xm/quantar-interface/(commit log)

2020-08-06 Good chunk of schematic including first draft of audio circuitry
    [quantar-interface.kicad_pcb, quantar-interface.sch]
2020-11-05 Done with schematic, ready to route
    [quantar-interface.sch]
2020-11-05 Correct package for 74HC14; Number the pad for the AP1506
    [quantar-interface.sch]
2020-11-08 Schematic revisions, first draft of layout
    [quantar-interface.kicad_pcb, quantar-interface.sch]
2020-11-08 Add fiducials for PCBA
    [quantar-interface.kicad_pcb]
2020-11-08 Add crappy notes of DK part numbers for later BOM
2020-11-08 Add bottom layer plane to analog area
    [quantar-interface.kicad_pcb]
2020-11-14 Add BOM
    [master_bom.ods, quantar-interface.kicad_pcb, quantar-interface.sch]
2020-11-15 Plot gerbers, generate JLCPCB BOM and picklist, move all JLC components to top side
    [quantar-interface-B_Cu.gbr, quantar-interface-B_Mask.gbr, quantar-interface-B_Paste.gbr, quantar-interface-B_SilkS.gbr, quantar-interface-Edge_Cuts.gbr, quantar-interface-F_Cu.gbr, quantar-interface-F_Mask.gbr, quantar-interface-F_Paste.gbr]
2020-12-05 BOM as ordered. Minor changes based on availability
    [master_bom.ods]
2020-12-05 PCBA files for REV A
    [jlcpcb_bom.csv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]
2020-12-05 Revision B
    [jlcpcb_bom.csv, master_bom.ods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]
